BanglaWarlock/Refined_FYP_Proto/website/circuit.png

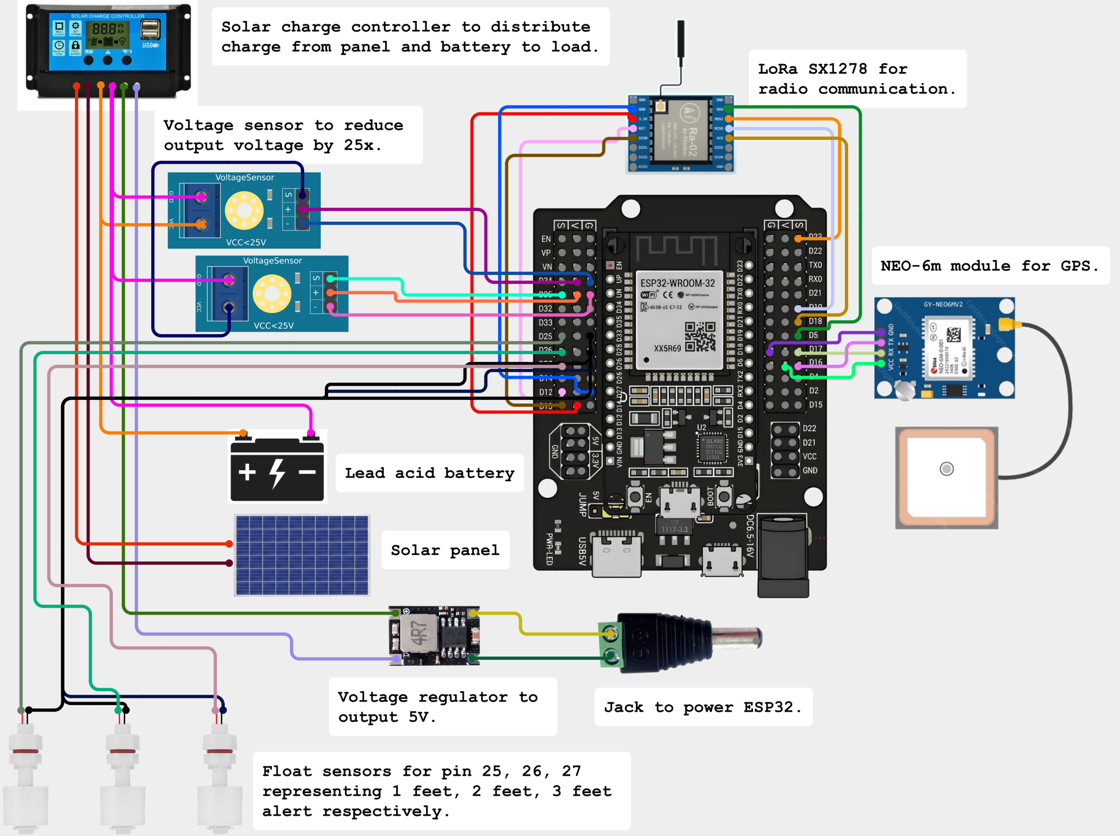
website/circuit.png
