BanglaWarlock/Refined_FYP_Proto/Architecture.png

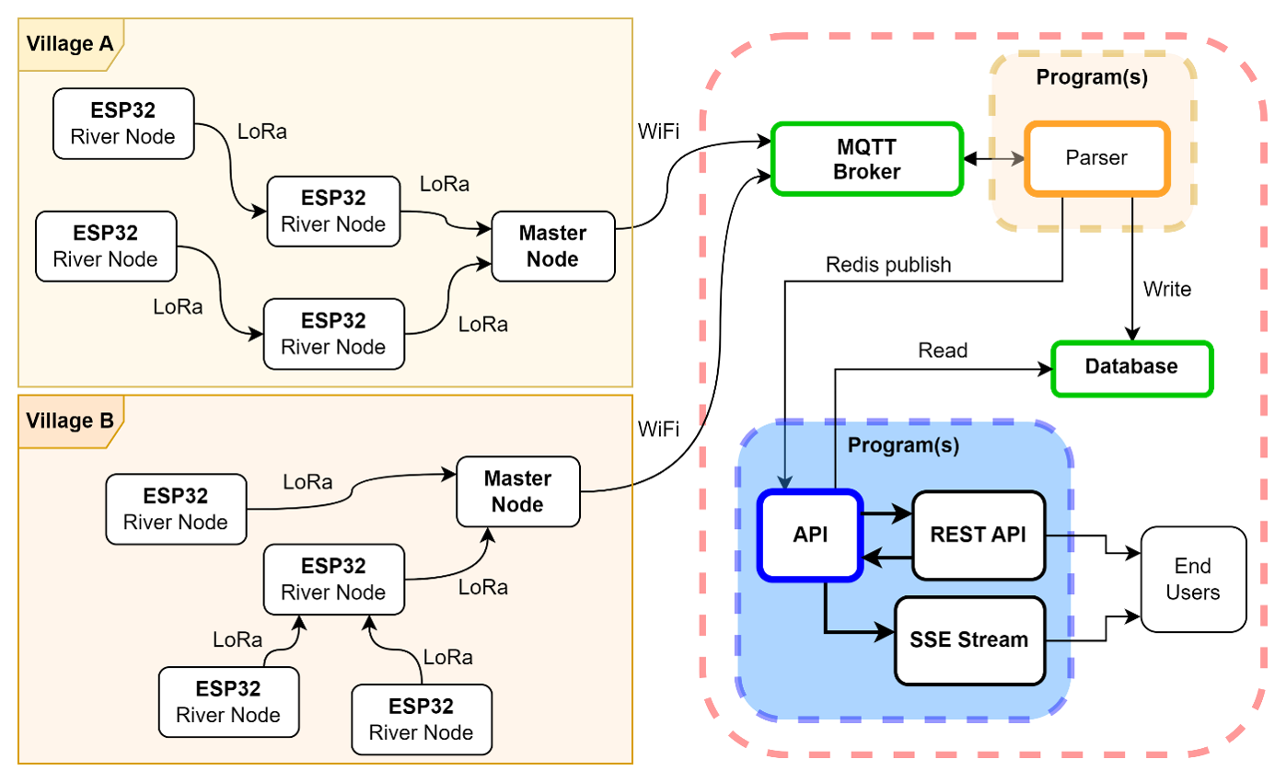
Architecture.png
