BanglaWarlock/Refined_FYP_Proto/hardware/mesh-chaining/river_node/mesh.ino

// Mesh layer: alert builders, discovery/registration FSM, heartbeat
// liveness, beacons, child eviction → node_lost. Spec: docs/PROTOCOL.md §5-§7.

void send_announce() {
    char pl[PACKET_MAX_LEN];
    snprintf(pl, sizeof(pl), "id=%s,village=%s,depth=%u,parent=%s,lat=%.6f,lng=%.6f",
             own_node_id, village, own_depth, active_parent_id, gps_lat, gps_lng);
    enqueueAlert(MSG_ALERT, ALERT_KEY_ANNOUNCE, "", pl);
    Serial.println("[ANNOUNCE] queued (reliable)");
}

void send_heartbeat() {
    static uint32_t seq = 0;
    char pl[PACKET_MAX_LEN], raw[PACKET_MAX_LEN];
    snprintf(pl, sizeof(pl), "id=%s,bat=%.2f,float_bits=%u,depth=%u,parent=%s,lat=%.6f,lng=%.6f,gps_fix=%u,seq=%lu",
             own_node_id, battery_voltage, float_bits, own_depth, active_parent_id, gps_lat, gps_lng,
             (uint8_t)gps_fix_valid, seq++);
    uint64_t mid = new_msg_id();
    format_packet(raw, sizeof(raw), mid, own_node_id, active_parent_id, MSG_HB, pl);
    pending_hb.sent_msg_id  = mid;
    pending_hb.retries++;
    enqueueLora(String(raw));
}

void send_alert_flood(uint8_t level) {
    char pl[PACKET_MAX_LEN];
    snprintf(pl, sizeof(pl), "type=flood,id=%s,level=%u,float_bits=0x%02X,bat=%.2f,lat=%.6f,lng=%.6f",
             own_node_id, level, float_bits, battery_voltage, gps_lat, gps_lng);
    enqueueAlert(MSG_ALERT, ALERT_KEY_FLOOD, "", pl);
    Serial.printf("[ALERT] Flood level=%u queued\n", level);
}

void send_alert_gps_signal_lost() {
    char pl[PACKET_MAX_LEN];
    snprintf(pl, sizeof(pl), "type=gps_signal_lost,id=%s,bat=%.2f,last_lat=%.6f,last_lng=%.6f",
             own_node_id, battery_voltage, gps_lat, gps_lng);
    enqueueAlert(MSG_ALERT, ALERT_KEY_GPS_SIGNAL, "", pl);
    Serial.println("[ALERT] GPS signal lost queued");
}

void send_alert_gps_fix_restored() {
    char pl[PACKET_MAX_LEN];
    snprintf(pl, sizeof(pl), "type=gps_restored,id=%s,bat=%.2f,lat=%.6f,lng=%.6f",
             own_node_id, battery_voltage, gps_lat, gps_lng);
    enqueueAlert(MSG_ALERT, ALERT_KEY_GPS_SIGNAL, "", pl);
    Serial.println("[ALERT] GPS fix restored queued");
}

void send_alert_gps_moved(double dist) {
    char pl[PACKET_MAX_LEN];
    snprintf(pl, sizeof(pl),
             "type=gps_moved,id=%s,bat=%.2f,dist=%.1f,lat=%.6f,lng=%.6f,home_lat=%.6f,home_lng=%.6f",
             own_node_id, battery_voltage, (float)dist, gps_lat, gps_lng, gps_home_lat, gps_home_lng);
    enqueueAlert(MSG_ALERT, ALERT_KEY_GPS_MOVED, "", pl);
    Serial.printf("[ALERT] GPS moved %.1fm queued\n", (float)dist);
}

void send_alert_battery() {
    char pl[PACKET_MAX_LEN];
    snprintf(pl, sizeof(pl), "type=battery,id=%s,bat=%.2f", own_node_id, battery_voltage);
    enqueueAlert(MSG_ALERT, ALERT_KEY_BATTERY, "", pl);
    Serial.println("[ALERT] Battery low queued");
}

void send_alert_crash(const char *reason) {
    char pl[PACKET_MAX_LEN];
    snprintf(pl, sizeof(pl), "type=crash,id=%s,reason=%s,bat=%.2f",
             own_node_id, reason, battery_voltage);
    enqueueAlert(MSG_ALERT, ALERT_KEY_CRASH, "", pl);
    Serial.printf("[CRASH] Alert queued: %s\n", reason);
}

// Relay lost its child — reliable report upstream; tag = child id so two
// simultaneous losses don't overwrite each other (PROTOCOL §7).
void send_alert_node_lost(const char *child, uint32_t down_s) {
    char pl[PACKET_MAX_LEN];
    snprintf(pl, sizeof(pl), "type=node_lost,id=%s,lost=%s,down_s=%lu,bat=%.2f",
             own_node_id, child, (unsigned long)down_s, battery_voltage);
    enqueueAlert(MSG_ALERT, ALERT_KEY_NODE_LOST, child, pl);
    Serial.printf("[ALERT] node_lost %s (down %.0fs) queued\n", child, (float)down_s);
}

// Liveness probe for a silent direct child — the child's CMD_ACK proves it
// alive (PROTOCOL §5).
void send_probe_ping(const char *child) {
    char pl[PACKET_MAX_LEN], raw[PACKET_MAX_LEN];
    snprintf(pl, sizeof(pl), "target=%s,data=ping", child);
    format_packet(raw, sizeof(raw), new_msg_id(), own_node_id, child, MSG_CMD, pl);
    enqueueLora(String(raw));
    Serial.printf("[PROBE] ping → %s\n", child);
}

void discoveryTask(void *pv) {
    for (;;) {
        switch (node_state) {

        case NODE_DISCOVERING: {
            led_set_pattern(LED_DISCOVERING);
            xSemaphoreTake(candidates_mutex, portMAX_DELAY);
            candidate_count = 0;
            xSemaphoreGive(candidates_mutex);
            char raw[PACKET_MAX_LEN];
            // DISCOVER with a known id — the response window must not start
            // until this frame has actually left the antenna (TX runs in a
            // separate task: queue wait + CAD + airtime all precede it)
            uint64_t disc_mid = new_msg_id();
            format_packet(raw, sizeof(raw), disc_mid, own_node_id, "ALL", MSG_DISCOVER, "");
            enqueueLora(String(raw));
            Serial.println("[DISC] Sent DISCOVER");
            uint32_t waited = 0;
            while (last_tx_msg_id != disc_mid && waited < 3000) {
                vTaskDelay(pdMS_TO_TICKS(10));
                waited += 10;
            }
            vTaskDelay(pdMS_TO_TICKS(DISC_WINDOW_MS));

            xSemaphoreTake(candidates_mutex, portMAX_DELAY);
            uint8_t cnt = candidate_count;
            disc_candidate_t best = {};
            if (cnt > 0) {
                int bi = 0;
                for (uint8_t i = 1; i < cnt; i++) {
                    const disc_candidate_t &c = candidates[i];
                    const disc_candidate_t &b = candidates[bi];
                    if (c.snr   > b.snr)   { bi = i; continue; }
                    if (c.snr   < b.snr)   continue;
                    if (c.rssi  > b.rssi)  { bi = i; continue; }
                    if (c.rssi  < b.rssi)  continue;
                    if (c.depth < b.depth)   bi = i;
                }
                best = candidates[bi];
            }
            xSemaphoreGive(candidates_mutex);

            if (cnt == 0) {
                Serial.println("[DISC] No candidates — retrying");
                vTaskDelay(pdMS_TO_TICKS(DISC_INTERVAL_MS));
            } else {
                char pl[PACKET_MAX_LEN];
                snprintf(pl, sizeof(pl), "id=%s", own_node_id);
                format_packet(raw, sizeof(raw), new_msg_id(), own_node_id, best.id, MSG_REG_REQ, pl);
                enqueueLora(String(raw));
                node_state = NODE_REGISTERING;
                led_set_pattern(LED_REGISTERING);
                Serial.printf("[DISC] REG_REQ → %s (depth=%u rssi=%d)\n", best.id, best.depth, best.rssi);
            }
            break;
        }

        case NODE_REGISTERING:
            if (xSemaphoreTake(reg_ack_sem, pdMS_TO_TICKS(REG_TIMEOUT_MS)) != pdTRUE) {
                Serial.println("[DISC] REG_ACK timeout — re-discovering");
                node_state = NODE_DISCOVERING;
            }
            break;

        case NODE_OPERATIONAL: {
            // one-shot: queue crash report on first tick after becoming operational
            static bool crash_alert_queued = false;
            if (!crash_alert_queued && pending_crash_reason[0]) {
                crash_alert_queued = true;
                send_alert_crash(pending_crash_reason);
            }
            vTaskDelay(pdMS_TO_TICKS(1000));
            // child liveness: passive last-seen; on timeout probe before
            // declaring missing — never report a node_lost on a hunch (§5)
            uint32_t now = millis();
            char ping_ids[4][NODE_ID_MAX_LEN]; uint8_t n_ping = 0;
            char lost_ids[4][NODE_ID_MAX_LEN]; uint32_t lost_s[4]; uint8_t n_lost = 0;
            xSemaphoreTake(children_mutex, portMAX_DELAY);
            for (auto it = child_regs.begin(); it != child_regs.end(); ) {
                child_reg_t &r = *it;
                bool silent = (r.last_seen_ms > 0 &&
                               now - r.last_seen_ms > CHILD_OFFLINE_TIMEOUT_MS);
                if (silent && r.probe_sent_ms == 0) {
                    r.probe_sent_ms = now;
                    r.probe_tries   = 1;
                    if (n_ping < 4) { strlcpy(ping_ids[n_ping++], r.id, NODE_ID_MAX_LEN); }
                    ++it;
                } else if (r.probe_sent_ms && now - r.probe_sent_ms >= PROBE_INTERVAL_MS) {
                    if (r.probe_tries >= PROBE_MAX_TRIES) {
                        Serial.printf("[RELAY] Child %s silent through %u probes — missing\n",
                                      r.id, r.probe_tries);
                        if (n_lost < 4) {
                            strlcpy(lost_ids[n_lost], r.id, NODE_ID_MAX_LEN);
                            lost_s[n_lost] = (now - r.last_seen_ms) / 1000;
                            n_lost++;
                        }
                        it = child_regs.erase(it);
                    } else {
                        r.probe_tries++;
                        r.probe_sent_ms = now;
                        if (n_ping < 4) { strlcpy(ping_ids[n_ping++], r.id, NODE_ID_MAX_LEN); }
                        ++it;
                    }
                } else {
                    ++it;
                }
            }
            xSemaphoreGive(children_mutex);
            for (uint8_t i = 0; i < n_ping; i++) send_probe_ping(ping_ids[i]);
            for (uint8_t i = 0; i < n_lost; i++) send_alert_node_lost(lost_ids[i], lost_s[i]);
            break;
        }

        case NODE_LOST_PARENT:
            led_set_pattern(LED_LOST_PARENT);
            xSemaphoreTake(children_mutex, portMAX_DELAY);
            child_regs.clear();
            xSemaphoreGive(children_mutex);
            xSemaphoreTake(alert_mutex, portMAX_DELAY);
            for (auto &a : alert_list) a.last_sent_ms = 0;
            xSemaphoreGive(alert_mutex);
            active_parent_id[0] = '\0';
            last_parent_seen_ms = 0;
            Serial.println("[DISC] Going back to discovering");
            node_state = NODE_DISCOVERING;
            break;
        }
        vTaskDelay(pdMS_TO_TICKS(1));
    }
}

void heartbeatTask(void *pv) {
    for (;;) {
        vTaskDelay(pdMS_TO_TICKS(ALERT_RETRY_MS));

        if (node_state != NODE_OPERATIONAL) {
            pending_hb = {};
            continue;
        }

        battery_voltage = read_battery_voltage();
        if (!battery_low_sent && battery_voltage < 10.5f) {
            send_alert_battery(); battery_low_sent = true;
        } else if (battery_low_sent && battery_voltage >= 11.5f) {
            battery_low_sent = false;
        }

        uint32_t now = millis();
        if (pending_hb.sent_msg_id == 0) {
            // adaptive heartbeat: any packet received from the parent already
            // proves it alive (last_parent_seen_ms) — only transmit when the
            // parent has been silent for a full interval
            if (last_parent_seen_ms == 0 || (now - last_parent_seen_ms >= HEARTBEAT_INTERVAL_MS)) {
                pending_hb.retries = 0;
                send_heartbeat();
                Serial.printf("[HB] Sent → %s\n", active_parent_id);
            }
        } else {
            // HB in flight — retry or declare parent lost
            if (now - pending_hb.last_sent_ms >= HB_RETRY_MS) {
                if (pending_hb.retries >= HB_MAX_RETRIES) {
                    Serial.printf("[HB] No ACK after %u tries — parent %s lost\n",
                                  HB_MAX_RETRIES, active_parent_id);
                    pending_hb = {};
                    node_state = NODE_LOST_PARENT;
                } else {
                    Serial.printf("[HB] Retry %u/%u → %s\n",
                                  pending_hb.retries + 1, HB_MAX_RETRIES, active_parent_id);
                    send_heartbeat();
                }
            }
        }
    }
}

void beaconTask(void *pv) {
    TickType_t last = xTaskGetTickCount();
    for (;;) {
        vTaskDelayUntil(&last, pdMS_TO_TICKS(BEACON_INTERVAL_MS));
        if (node_state != NODE_OPERATIONAL) continue;
        xSemaphoreTake(children_mutex, portMAX_DELAY);
        bool has_ch = !child_regs.empty();
        xSemaphoreGive(children_mutex);
        if (!has_ch) continue;
        char raw[PACKET_MAX_LEN];
        format_packet(raw, sizeof(raw), new_msg_id(), own_node_id, "ALL", MSG_BEACON, "");
        enqueueLora(String(raw));
        Serial.println("[BEACON] sent");
    }
}
