BanglaWarlock/Refined_FYP_Proto/(commit log)

2026-09-16 River node firmware v2: CAD channel discipline, seq-based alert freshness, node_lost with suppression; protocol spec + deployment guide
2026-09-16 Master node v2: CAD radio, seq alert dedup, node_lost with offline suppression, deploy-slug topics; provisioning sketches with lora_sf/deploy keys
2026-09-16 DEPLOYMENT.md: exact secret sources (SSH key gen, Atlas driver URI vs SQL interface); add iot-service .env.example
2026-09-16 Protocol v2.1: adaptive heartbeats (any parent packet = keepalive), probe-before-declare liveness on both master and relays; revert Caddy to nginx (HTTP)
    [handlers.ino, lora.ino, mesh.ino, protocol.h, river_node.ino, status.ino]
2026-09-16 river node: guard LilyGO Vext power-rail pin behind #ifdef (not defined on generic ESP32 boards)
2026-09-16 Fix FIFO over-read: RX reads exact RxDone byte count instead of stale available(); hard frame validation (16-hex msg_id, printable ids, type bounds) rejects ghost packets
    [lora.ino]
2026-09-16 Fix ISR/task SPI race behind ghost packets: LoRa lib gains ISR-safe spinlock on singleTransfer + onDio0Rise; firmware ISR callbacks become flag-sets, RX task polls with mid-read abort
    [lora.ino, master_node.ino, river_node.ino]
2026-09-16 Discovery: widen response window to 2s (window starts at enqueue; must cover CAD+airtime+jitter) and spread responder jitter 50-550ms for multi-responder desks
    [handlers.ino, protocol.h]
2026-09-16 RX via parsePacket() polling - no DIO0 dependency for reception; DIO0 ISR kept only for CAD (fails open); river RX silence isolated to DIO0 interrupt path
    [lora.ino, master_node.ino, river_node.ino]
2026-09-16 Frame harvesting: recover every self-describing frame from whatever the FIFO yields (ghost reads span historical writes); drop own-source ghosts; tolerant DISC_RESP defaults for truncated harvest pay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
2026-09-16 Dual-path RX: DIO0 ISR fast path + parsePacket() poll fallback (DIO0-dead nodes); fixes master losing packets to ISR-swallowed IRQ flags
    [lora.ino]
2026-09-16 Discovery window starts when DISCOVER actually leaves the antenna (tx-completion sync); [RADIO] RX/TX/CAD state transition debug lines
2026-09-16 Website: village filter dropdown on node table
2026-09-16 Master: [RADIO] RX/TX/CAD state lines (parity with river); river re-discovery cadence 10s -> 5s for marginal-link re-acquisition
2026-09-16 Validate claimed node ids (REG_REQ both sides, alert origin, REG_ACK parent) - FIFO residue glued into payloads must never enter mesh state; corrupt registrations are rejected and retried
2026-09-16 CAD via register polling (new LoRa.cadResult() API) with ISR fast path - CAD no longer depends on DIO0 interrupts; fixes 1.2s blind CAD spin storms seen on both boards
    [lora.ino]
2026-09-16 Demo firmware build: hardware/demo/{river_node,master_node} — 1:1 pairing, config.h per node (no NVS), fire-and-forget HB, alerts retry-until-ACK, seq dedup, link-loss re-registration, reconnect-frie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
2026-09-16 demo master: add missing depth field to registered_node
    [config.h, master_node.ino]
2026-09-16 Demo firmware: revert to pristine LoRa library, drop CAD entirely, poll-only RX (no DIO0/interrupt dependency); patched lib archived with mesh-chaining build
    [config.h, lora.ino, master_node.ino, river_node.ino]
2026-09-16 demo: remove unused CAD constants
2026-09-17 demo river: handle_reg_ack now sets NODE_OPERATIONAL + announces (state was stuck in REGISTERING despite successful REG_ACK)
    [app.ino]
2026-09-17 Demo: master republishes topology every 60s; river re-announces every ~5min - topology converges after master reboot or heartbeat-only reconnect
    [app.ino, status.ino]
2026-09-17 Refactor node registration and heartbeat handling; improve float sensor anomaly detection and UI updates for real-time event stream
2026-09-17 Add circuit diagram to architecture section and update .env.example for MQTT_DEPLOY
